nledez/printer/doc/src/img/DSC04834.jpg

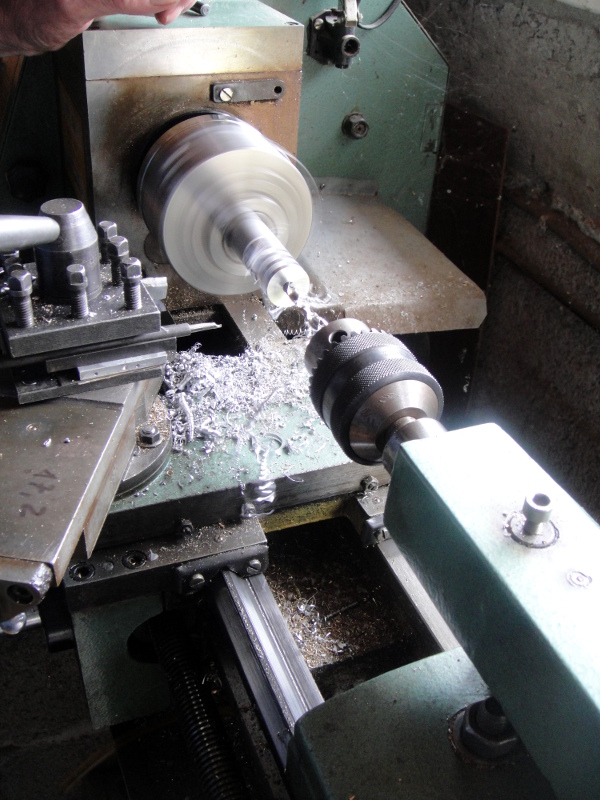
doc/src/img/DSC04834.jpg
