nledez/printer/doc/src/img/DSC04835.jpg

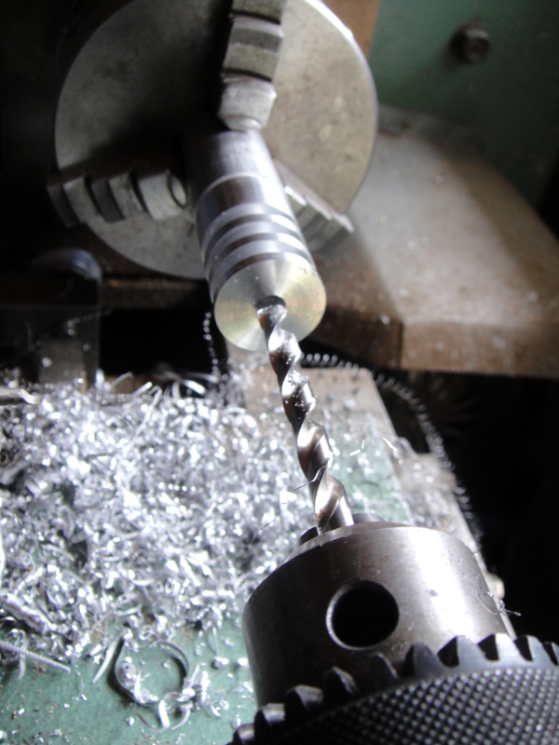
doc/src/img/DSC04835.jpg
