nledez/printer/doc/src/img/DSC04836.jpg

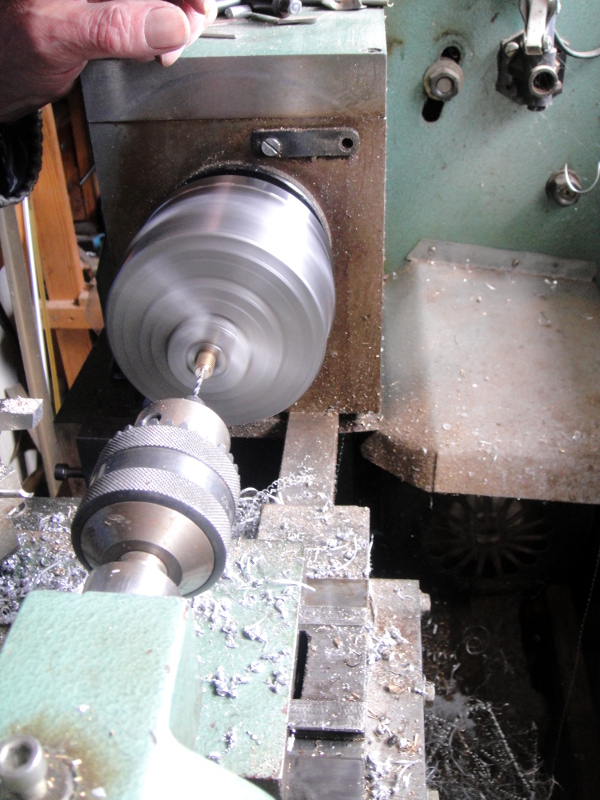
doc/src/img/DSC04836.jpg
