nledez/printer/doc/src/img/DSC04837.jpg

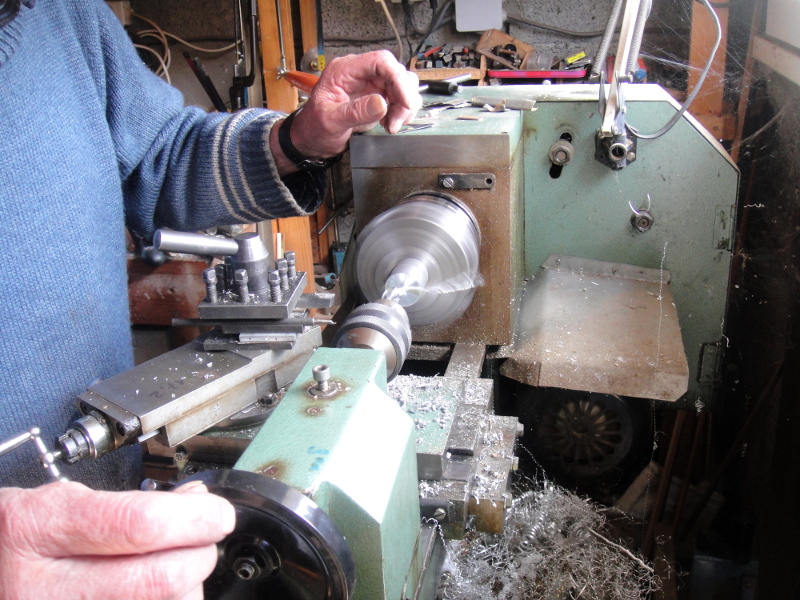
doc/src/img/DSC04837.jpg
