nledez/printer/doc/src/img/DSC04839.jpg

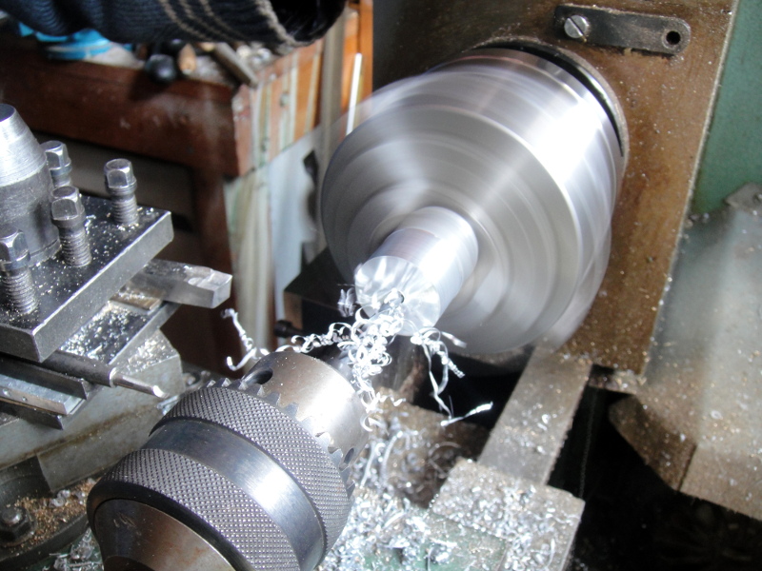
doc/src/img/DSC04839.jpg
