nledez/printer/doc/src/img/DSC04840.jpg

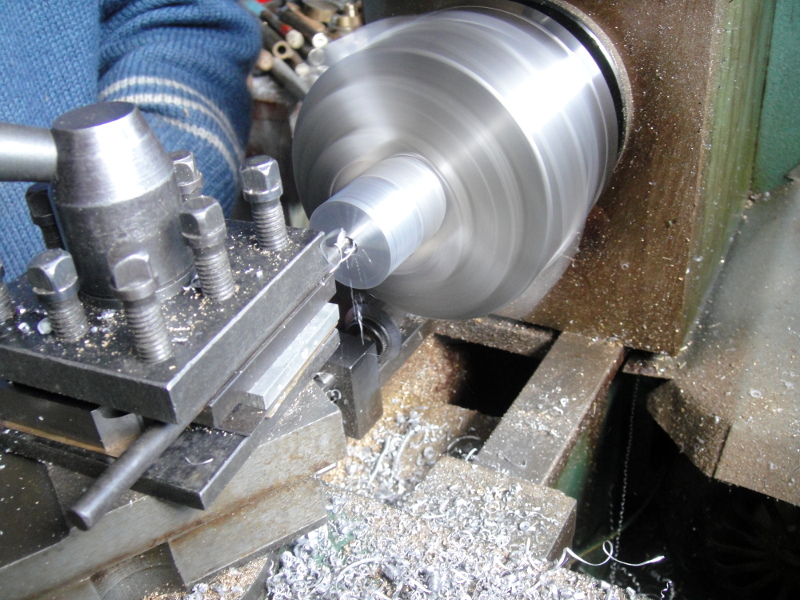
doc/src/img/DSC04840.jpg
