nledez/printer/doc/src/img/DSC04842.jpg

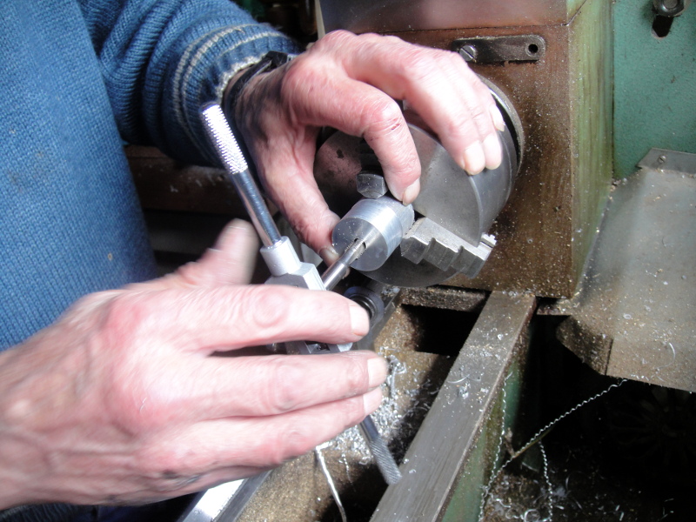
doc/src/img/DSC04842.jpg
