nledez/printer/doc/src/img/DSC04844.jpg

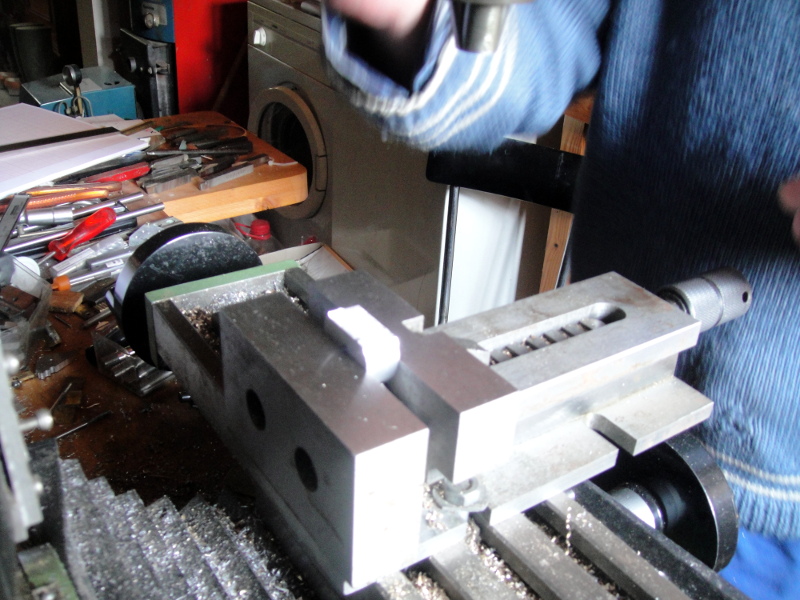
doc/src/img/DSC04844.jpg
