nledez/printer/doc/src/img/DSC04845.jpg

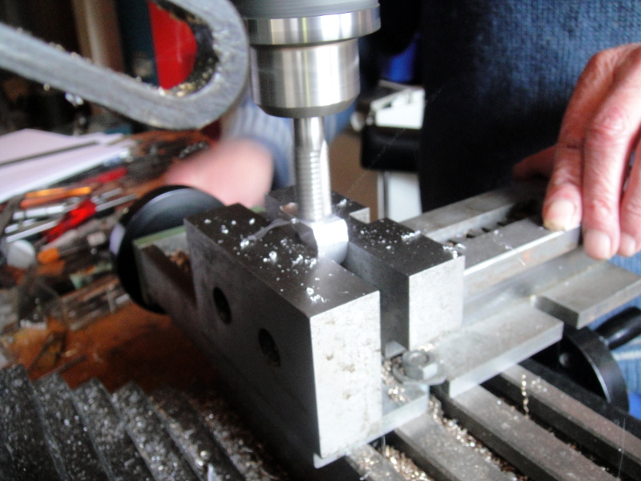
doc/src/img/DSC04845.jpg
