nledez/printer/doc/src/img/DSC04846.jpg

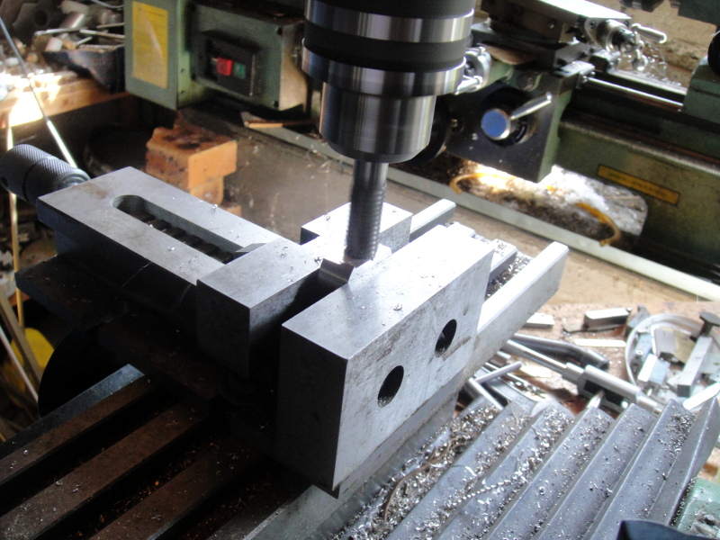
doc/src/img/DSC04846.jpg
