nledez/printer/doc/src/img/DSC04848.jpg

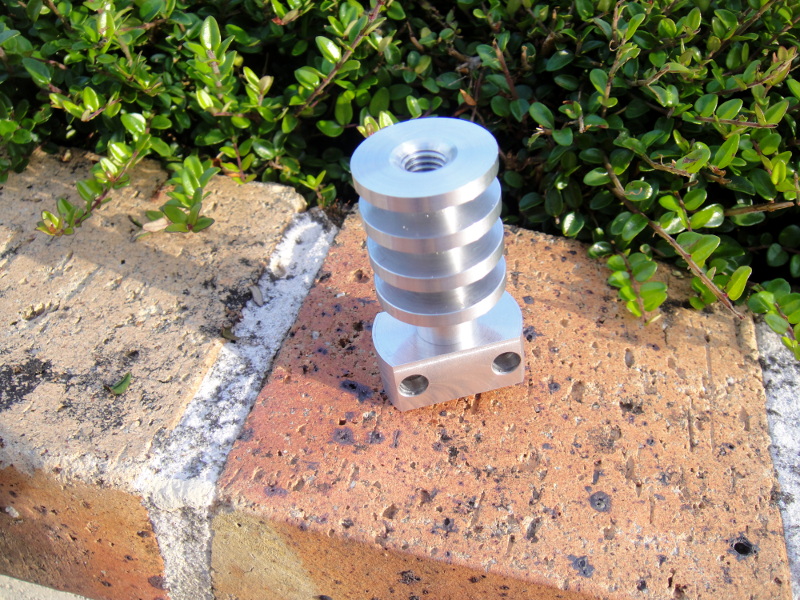
doc/src/img/DSC04848.jpg
