nledez/printer/doc/src/img/frame.jpg

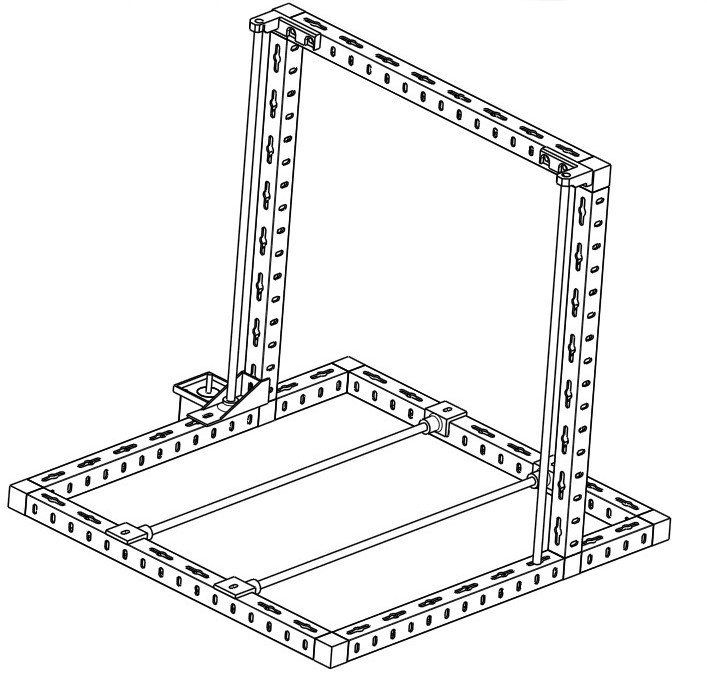
doc/src/img/frame.jpg
