nledez/printer/doc/src/img/funduino01.jpg

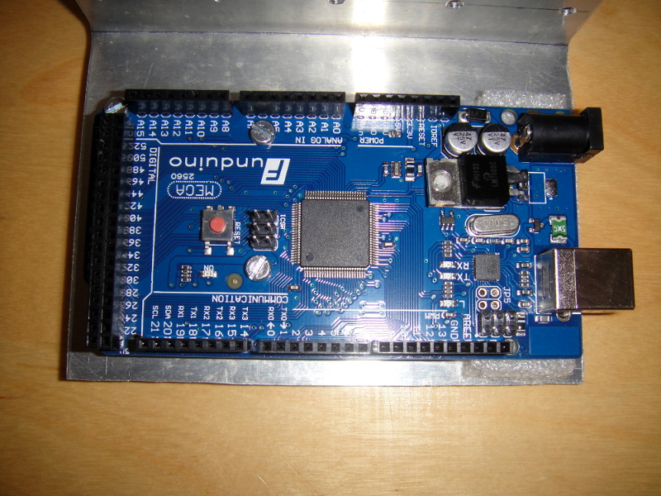
doc/src/img/funduino01.jpg
