nledez/printer/doc/src/img/ramps01.jpg

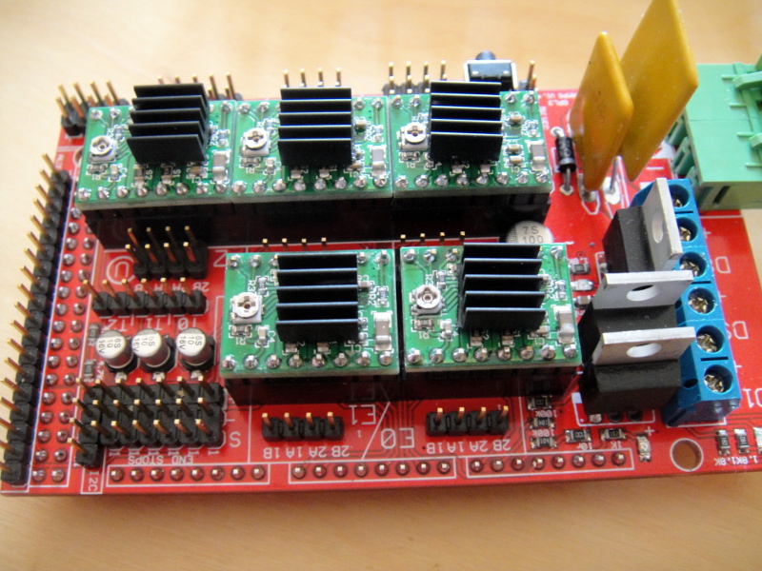
doc/src/img/ramps01.jpg
