nledez/printer/frame/printer.stp

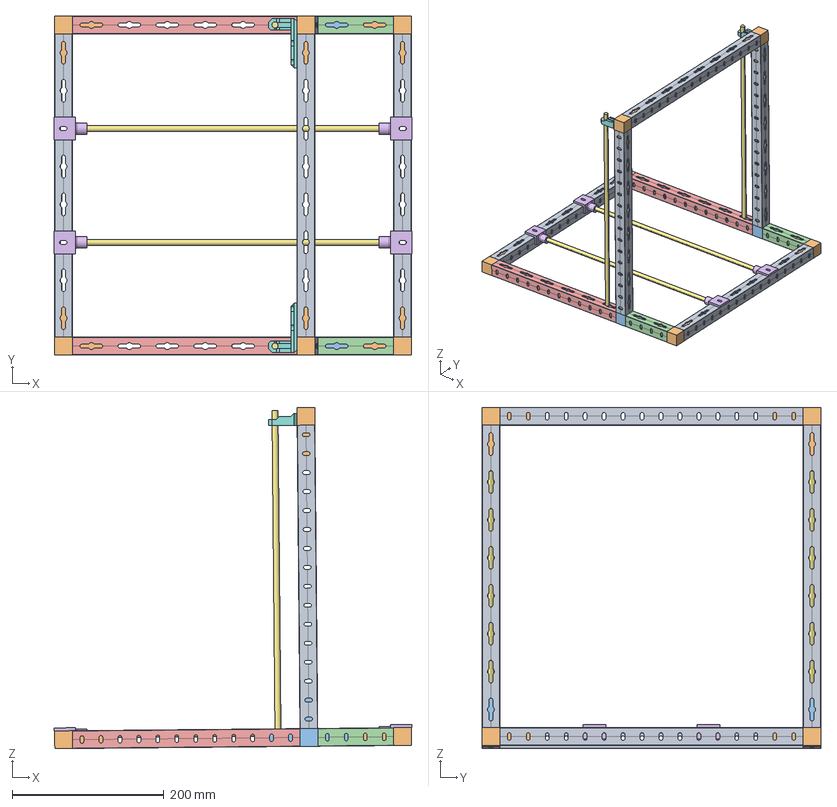
[picture p20: CAD file, 2014-05-22]
frame/printer.stp
471.5 x 447.0 x 450.2 mm
