nledez/printer/head/core.stl

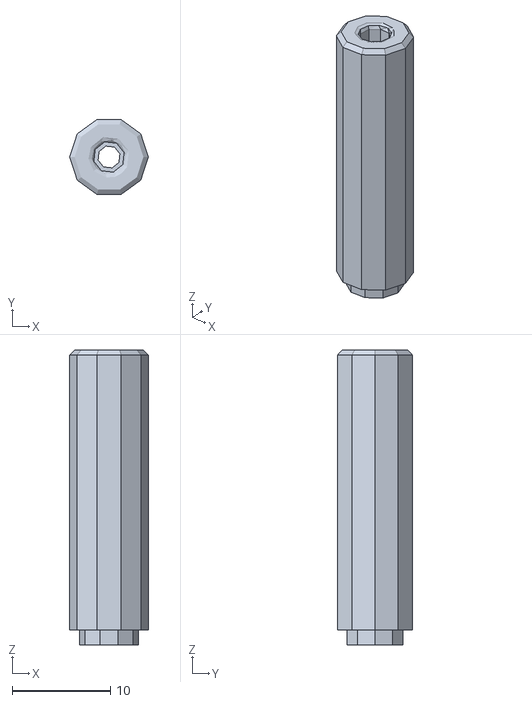
[picture p21: CAD file, 2014-06-01]
head/core.stl
8.00 x 7.61 x 30.0
