nledez/printer/import/Prusa_Mendel_i3_Rework/ENDSTOP-Z-HOLDER-V2.stl

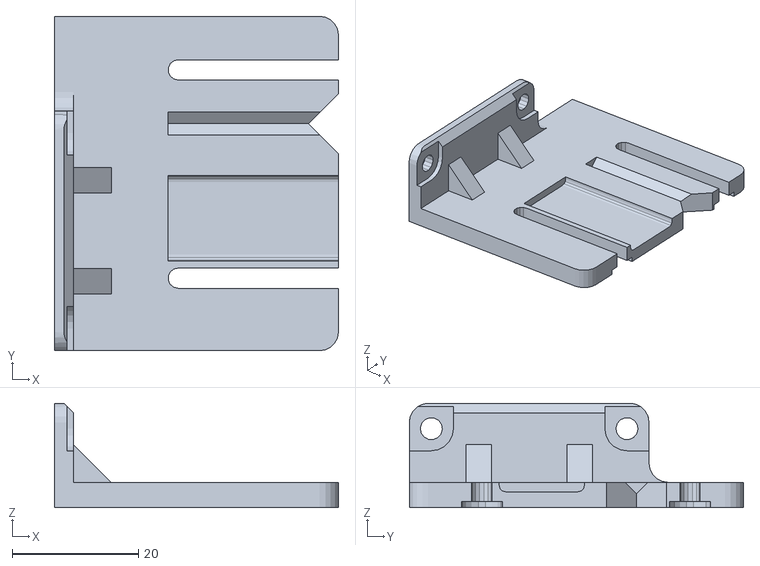
[picture p22: CAD file, 2014-05-20]
import/Prusa_Mendel_i3_Rework/ENDSTOP-Z-HOLDER-V2.stl
45.0 x 53.0 x 16.5
