nledez/printer/specific/Z-Axis-Top-Right.stl

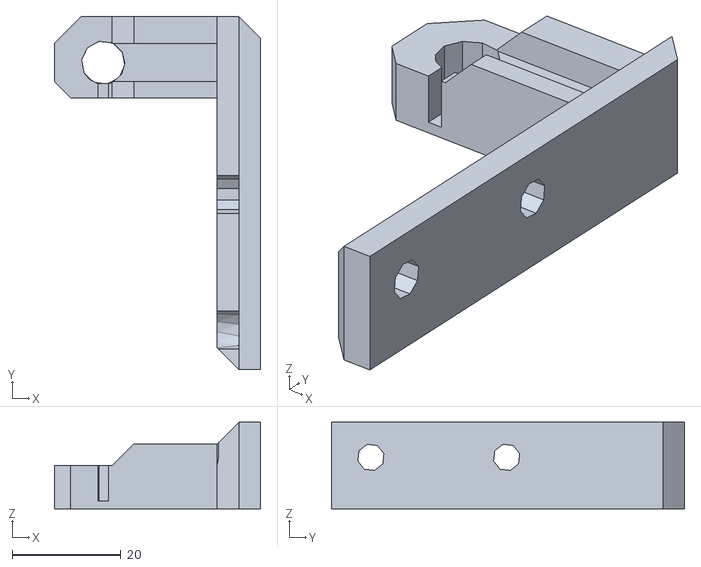
[picture p23: CAD file, 2014-05-22]
specific/Z-Axis-Top-Right.stl
38.0 x 65.0 x 16.0
