nledez/printer/tubes/profile_450.stl

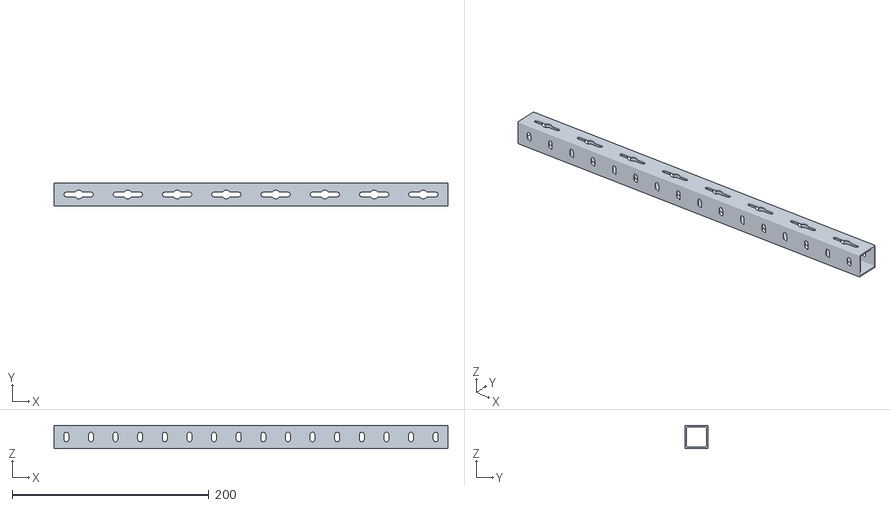
[picture p24: CAD file, 2014-05-17]
tubes/profile_450.stl
400.0 x 23.5 x 23.5
