nledez/printer/head/cooler.stl

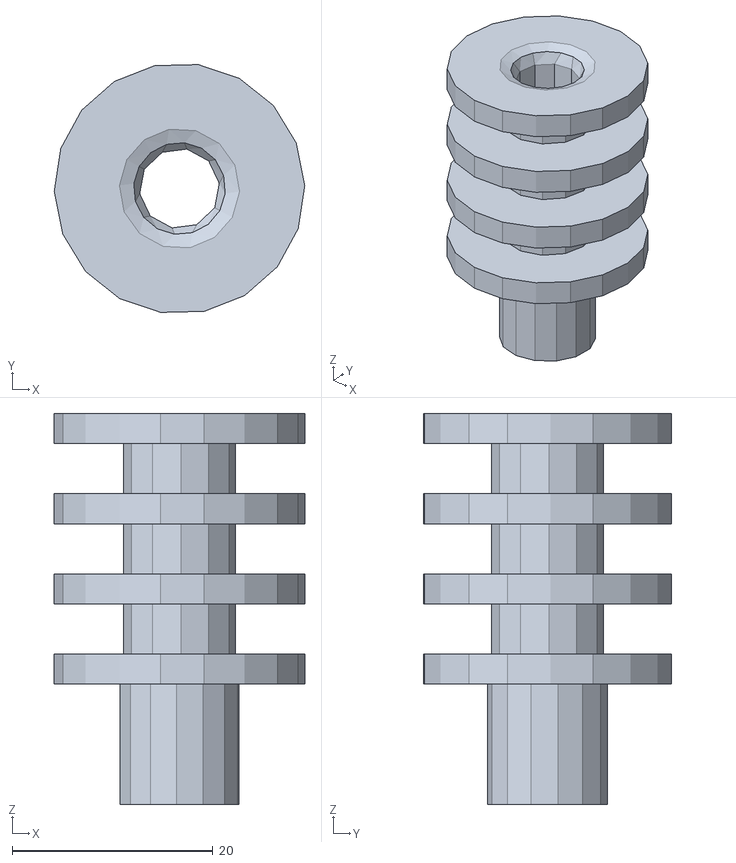
[picture p25: CAD file, 2014-06-01]
head/cooler.stl
25.0 x 24.7 x 39.0
