nledez/printer/import/Prusa_Mendel_i3_Rework/BODY-EXTRUDEUR-WADE-with-support.stl

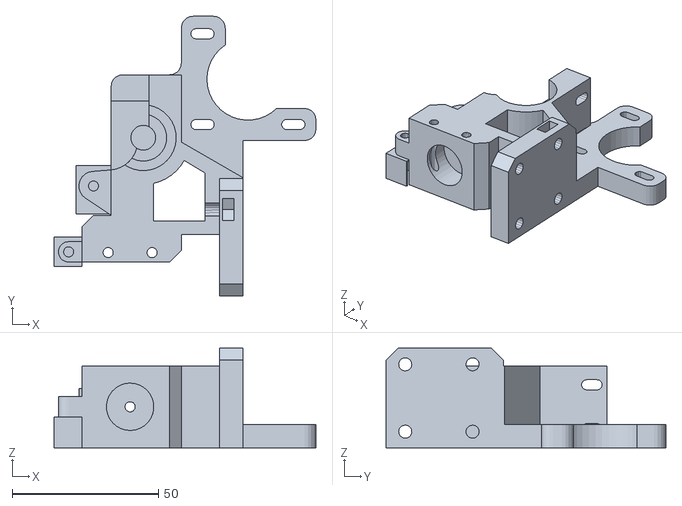
[picture p26: CAD file, 2014-05-20]
import/Prusa_Mendel_i3_Rework/BODY-EXTRUDEUR-WADE-with-support.stl
89.5 x 95.5 x 34.0
