nledez/printer/tubes/L.stl

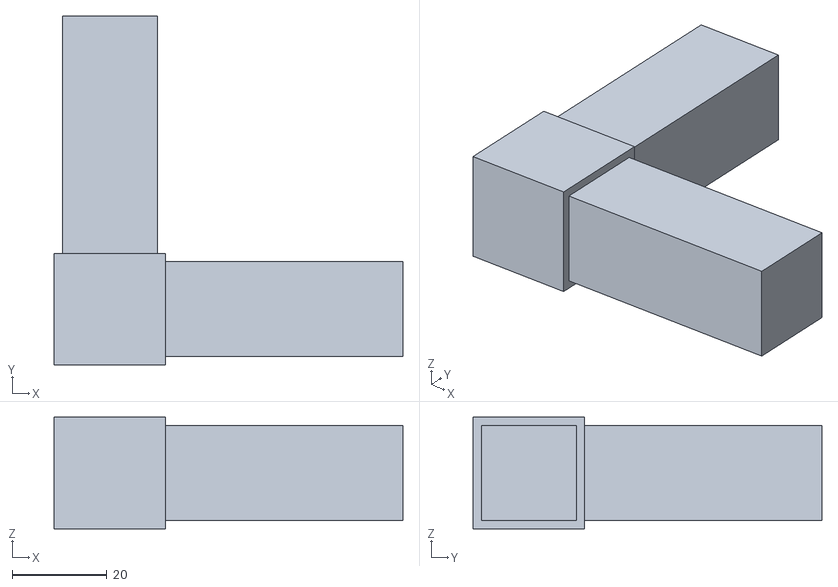
[picture p27: CAD file, 2014-05-17]
tubes/L.stl
73.5 x 73.5 x 23.5
