nledez/printer/head/heater.stl

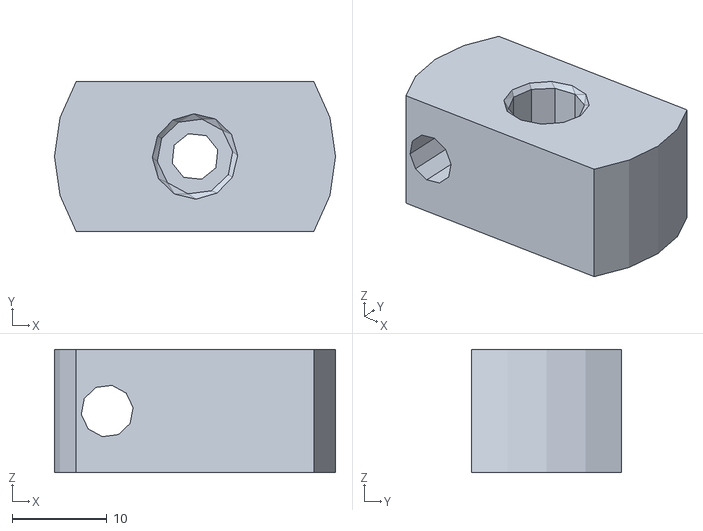
[picture p28: CAD file, 2014-06-01]
head/heater.stl
29.6 x 15.8 x 13.0
