nledez/printer/import/Prusa_Mendel_i3_Rework/Y-MOTOR.stl

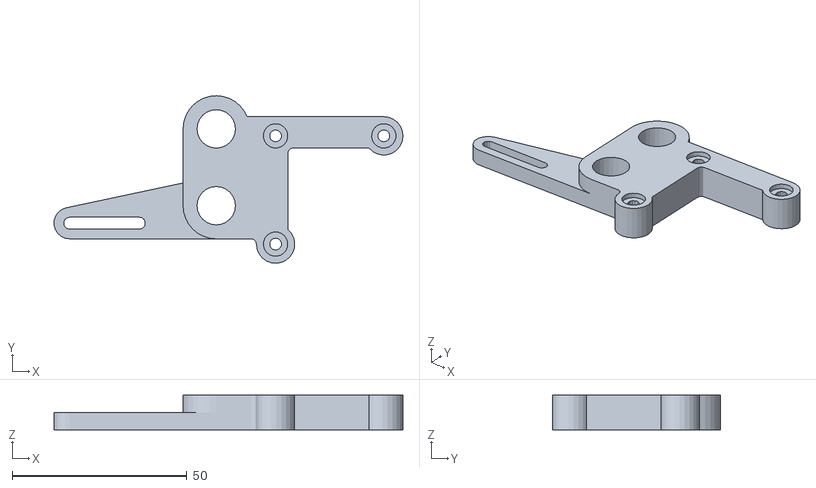
[picture p29: CAD file, 2014-05-20]
import/Prusa_Mendel_i3_Rework/Y-MOTOR.stl
100.0 x 48.0 x 10.0
