nledez/printer/specific/support_stub.stl

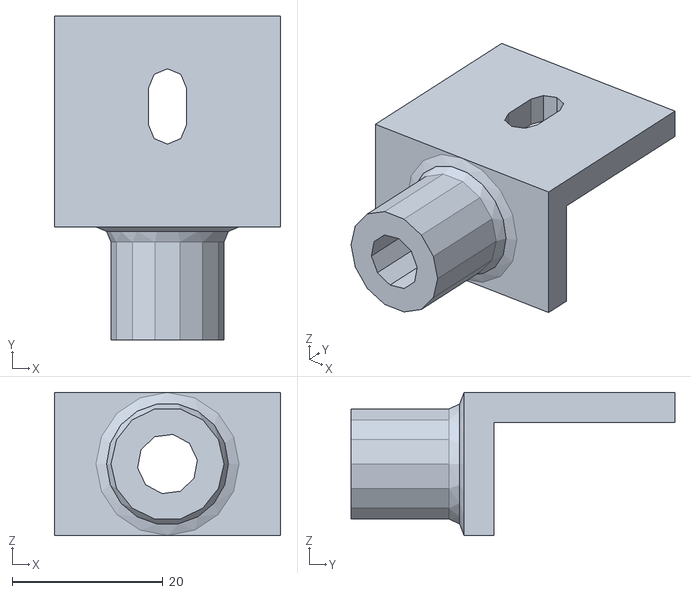
[picture p30: CAD file, 2014-05-19]
specific/support_stub.stl
30.0 x 43.0 x 19.0
