nledez/printer/head/printing_nozzle.stl

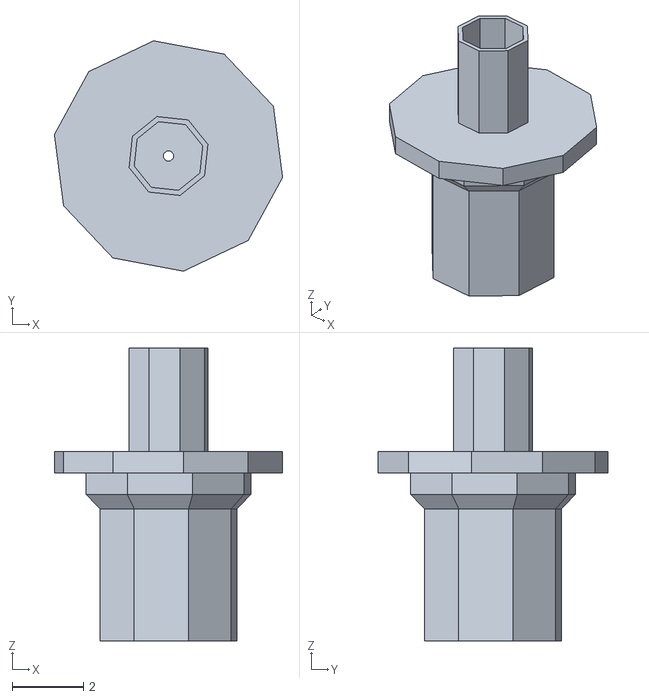
[picture p31: CAD file, 2014-05-23]
head/printing_nozzle.stl
6.39 x 6.45 x 8.20
