nledez/printer/import/Prusa_Mendel_i3_Rework/Z-AXIS-TOP-RIGHT-V2.stl

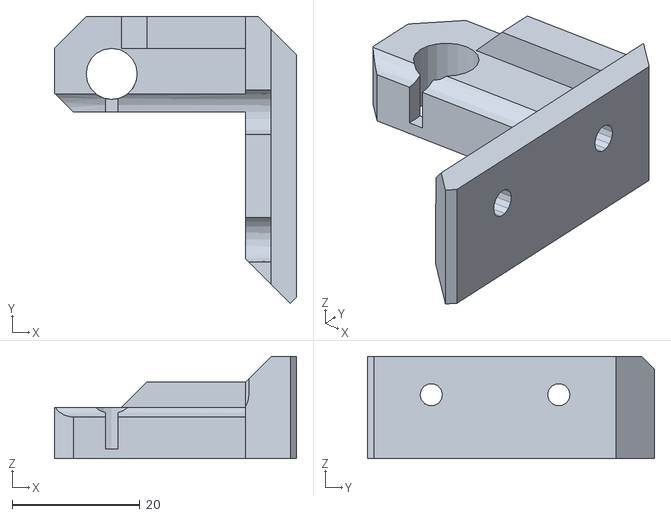
[picture p32: CAD file, 2014-05-20]
import/Prusa_Mendel_i3_Rework/Z-AXIS-TOP-RIGHT-V2.stl
38.0 x 45.0 x 16.0
