nledez/printer/tubes/T.stl

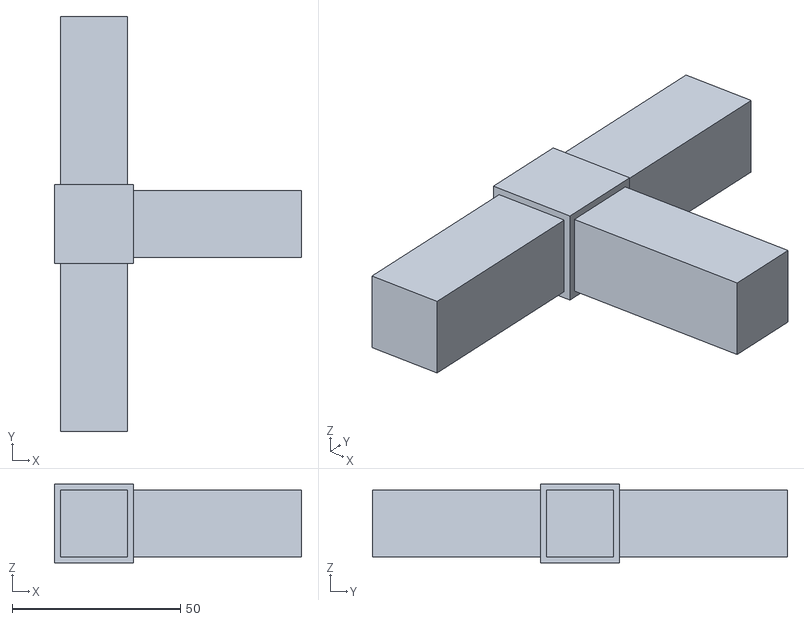
[picture p33: CAD file, 2014-05-17]
tubes/T.stl
73.5 x 123.5 x 23.5
