nledez/printer/import/Prusa_Mendel_i3_Rework/FAN-DUCT.stl

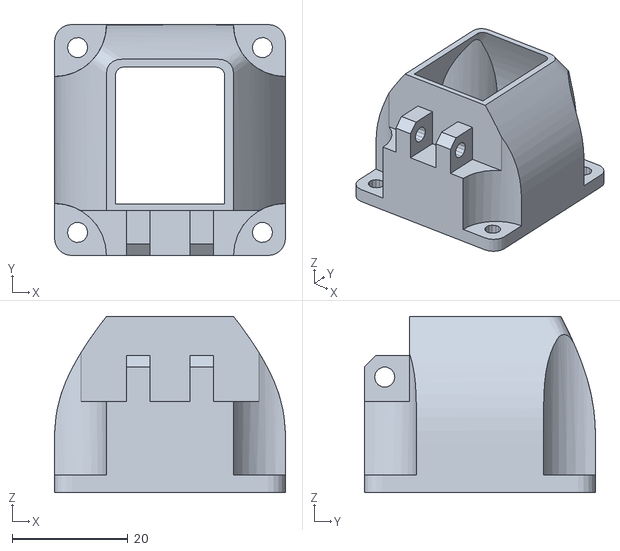
[picture p34: CAD file, 2014-05-20]
import/Prusa_Mendel_i3_Rework/FAN-DUCT.stl
40.0 x 40.0 x 30.5
