nledez/printer/tubes/profile_150.stl

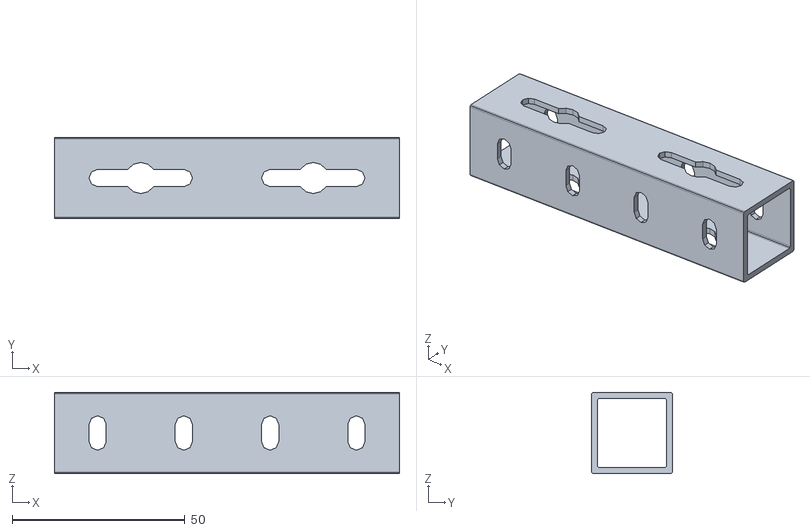
[picture p35: CAD file, 2014-05-17]
tubes/profile_150.stl
100.0 x 23.5 x 23.5
