nledez/printer/import/Prusa_Mendel_i3_Rework/WADE-BIG-GEAR.stl

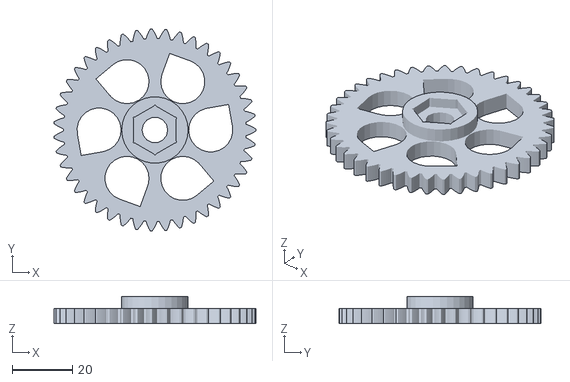
[picture p36: CAD file, 2014-05-20]
import/Prusa_Mendel_i3_Rework/WADE-BIG-GEAR.stl
66.9 x 67.0 x 9.00
