nledez/printer/tubes/profile_300.stl

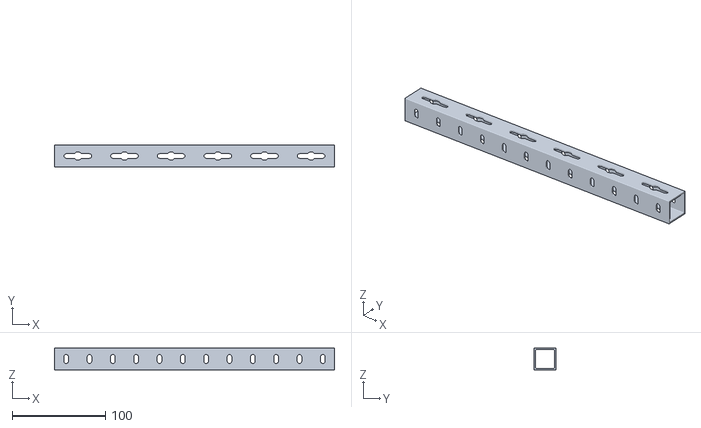
[picture p37: CAD file, 2014-05-17]
tubes/profile_300.stl
300.0 x 23.5 x 23.5
