nledez/printer/import/Prusa_Mendel_i3_Rework/BODY-EXTRUDEUR-WADE.stl

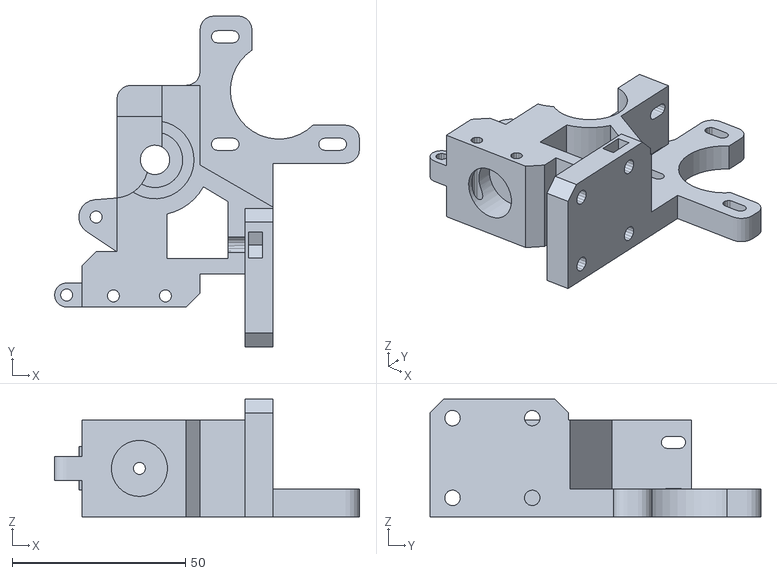
[picture p38: CAD file, 2014-05-20]
import/Prusa_Mendel_i3_Rework/BODY-EXTRUDEUR-WADE.stl
88.0 x 95.5 x 34.0
