nledez/printer/import/Prusa_Mendel_i3_Rework/BODY-EXTRUDEUR-WADE-1.75mm-with-support.stl

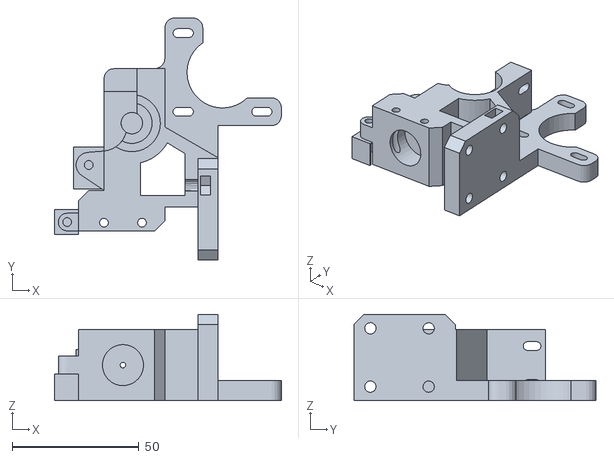
[picture p39: CAD file, 2014-05-20]
import/Prusa_Mendel_i3_Rework/BODY-EXTRUDEUR-WADE-1.75mm-with-support.stl
89.5 x 95.5 x 34.0
