nledez/printer/import/Prusa_Mendel_i3_Rework/Y-IDLER.stl

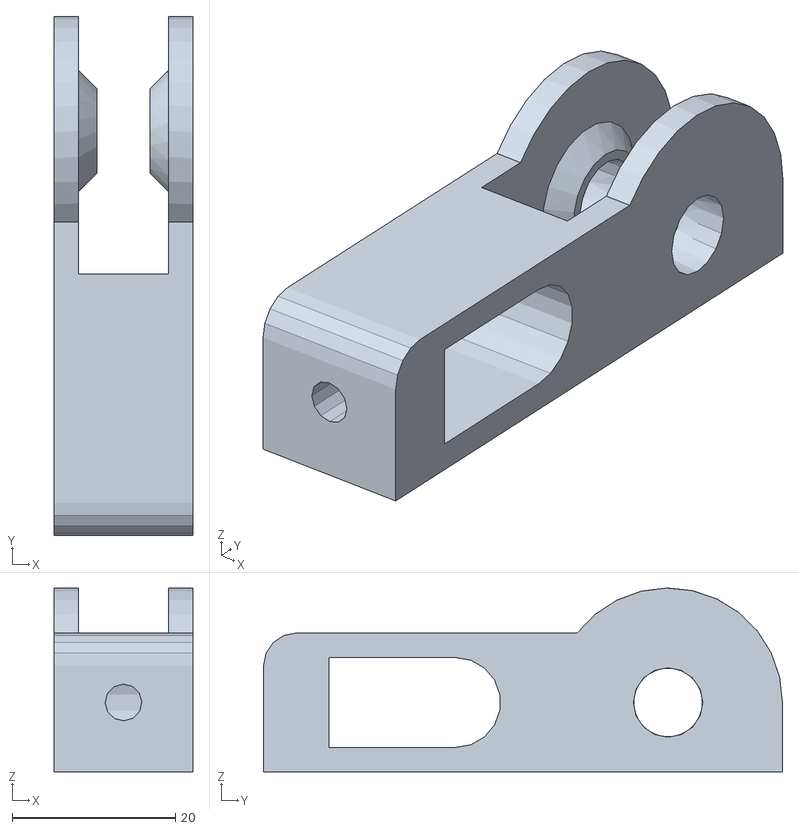
[picture p40: CAD file, 2014-05-20]
import/Prusa_Mendel_i3_Rework/Y-IDLER.stl
17.0 x 63.5 x 22.5
