nledez/printer/import/Prusa_Mendel_i3_Rework/Y-BELT-HOLDER.stl

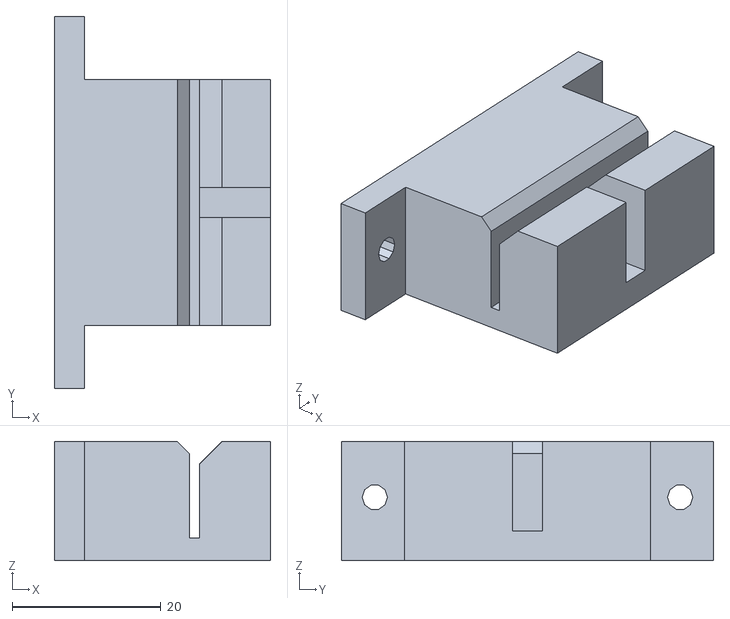
[picture p41: CAD file, 2014-05-20]
import/Prusa_Mendel_i3_Rework/Y-BELT-HOLDER.stl
29.0 x 50.0 x 16.0
