nledez/printer/import/Prusa_Mendel_i3_Rework/Z-AXIS-BOTTOM-RIGHT-V2.stl

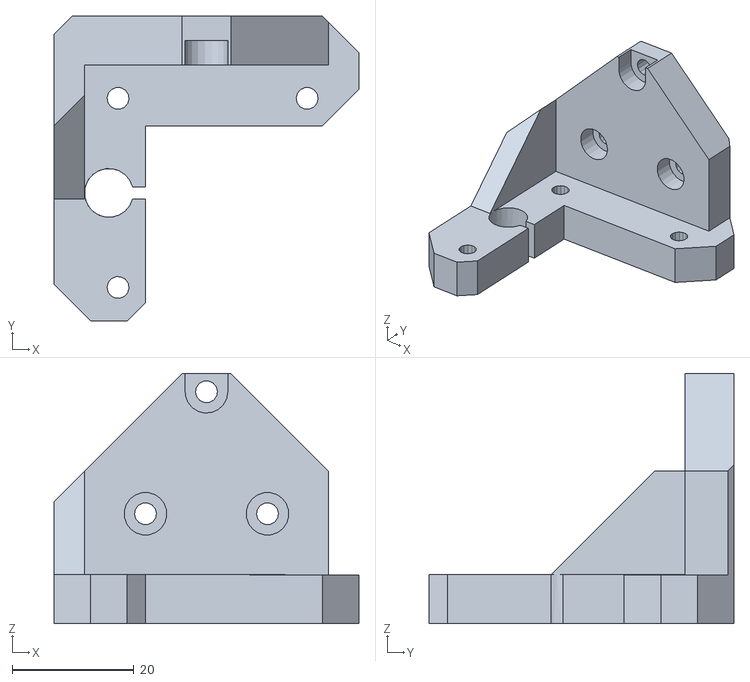
[picture p42: CAD file, 2014-05-20]
import/Prusa_Mendel_i3_Rework/Z-AXIS-BOTTOM-RIGHT-V2.stl
50.0 x 50.0 x 41.0
