nledez/printer/import/Prusa_Mendel_i3_Rework/X-CARRIAGE.stl

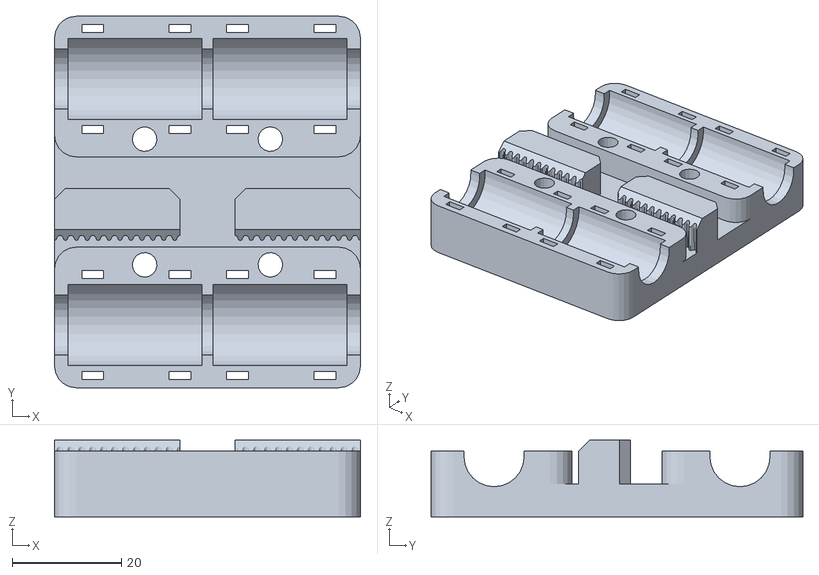
[picture p43: CAD file, 2014-05-20]
import/Prusa_Mendel_i3_Rework/X-CARRIAGE.stl
56.0 x 68.0 x 14.0
