nledez/printer/import/Prusa_Mendel_i3_Rework/Y-CORNERS.stl

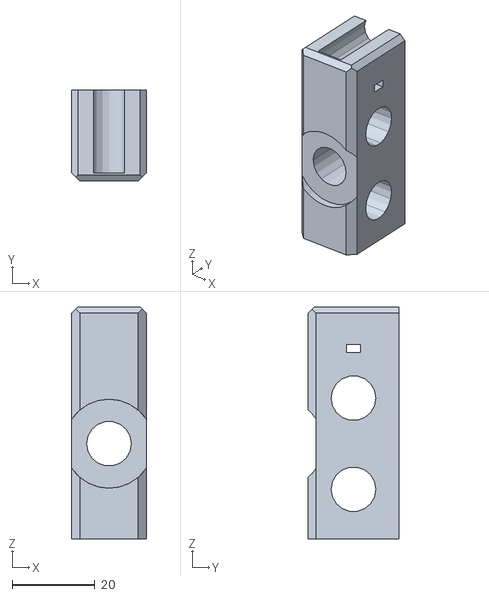
[picture p44: CAD file, 2014-05-20]
import/Prusa_Mendel_i3_Rework/Y-CORNERS.stl
18.0 x 22.0 x 56.0
