nledez/printer/import/Prusa_Mendel_i3_Rework/X-END-IDLER.stl

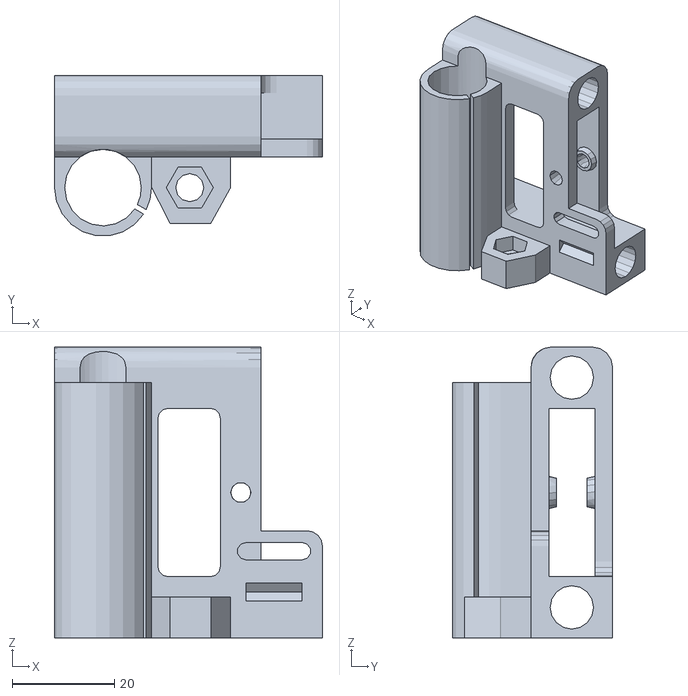
[picture p45: CAD file, 2014-05-20]
import/Prusa_Mendel_i3_Rework/X-END-IDLER.stl
52.5 x 31.4 x 57.0
