nledez/printer/import/Prusa_Mendel_i3_Rework/EXTRUDER-IDLER-avec-guide.stl

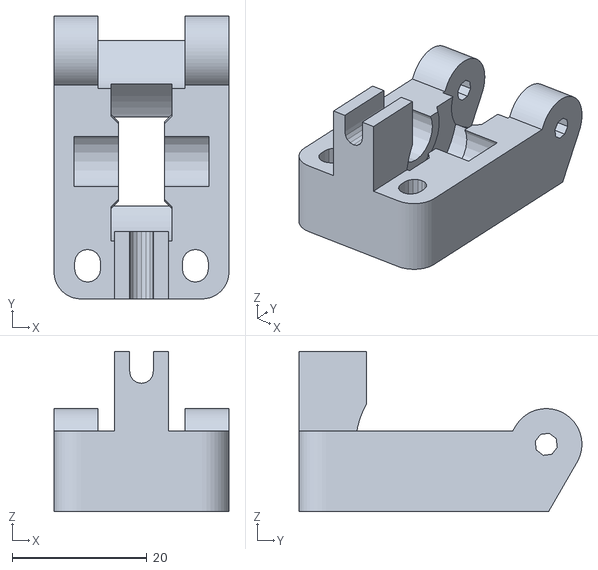
[picture p46: CAD file, 2014-05-20]
import/Prusa_Mendel_i3_Rework/EXTRUDER-IDLER-avec-guide.stl
26.0 x 42.0 x 23.8
