nledez/printer/import/Prusa_Mendel_i3_Rework/X-END-MOTOR-V2.stl

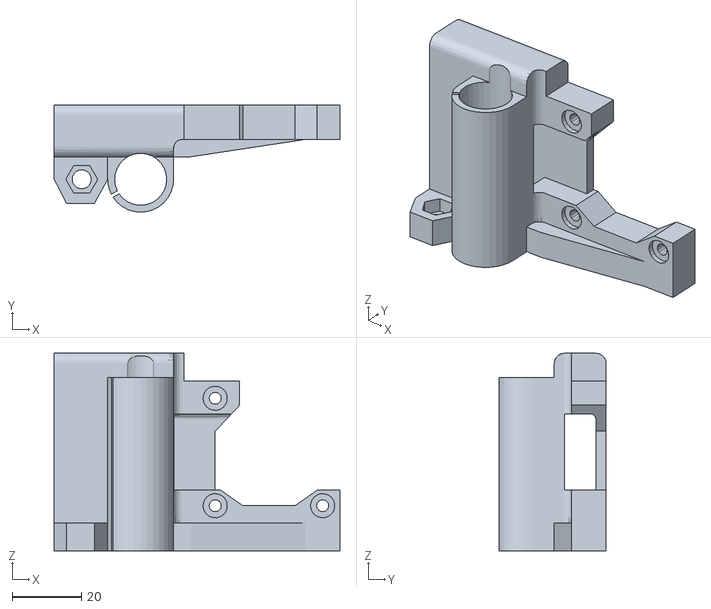
[picture p47: CAD file, 2014-05-20]
import/Prusa_Mendel_i3_Rework/X-END-MOTOR-V2.stl
82.5 x 31.0 x 57.0
