nledez/printer/import/Prusa_Mendel_i3_Rework/WADE-SMALL-GEAR.stl

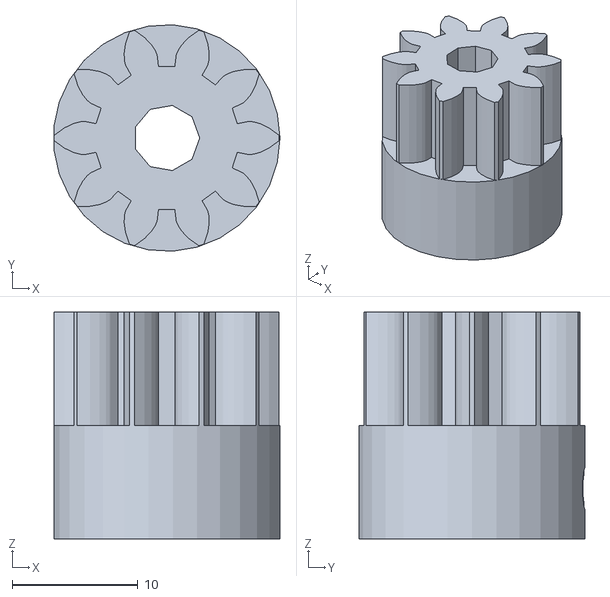
[picture p48: CAD file, 2014-05-20]
import/Prusa_Mendel_i3_Rework/WADE-SMALL-GEAR.stl
17.9 x 18.0 x 18.0
