nledez/printer/(list of files, cad)

Other CAD files:
specific/Z-Axis-Top-Left.stl
import/Prusa_Mendel_i3_Rework/Z-AXIS-TOP-LEFT-V2.stl
import/Prusa_Mendel_i3_Rework/Z-AXIS-BOTTOM-LEFT-V2.stl
frame/printer.CATProduct
head/cooler.CATPart
head/core.CATPart
head/head.CATProduct
head/heater.CATPart
head/printing_nozzle.CATPart
import/Prusa_Mendel_i3_Rework/ARDUINO-WASHER.stl
specific/Motor-Support-bottom-left.CATPart
specific/Motor.CATPart
specific/Motor_Support_bottom_right.CATPart
specific/Z-Axis-Top-Left.CATPart
specific/Z-Axis-Top-Right.CATPart
specific/stub_X.CATPart
specific/stub_Z.CATPart
specific/support_stub.CATPart
tubes/L.CATPart
tubes/T.CATPart
tubes/profile_150.CATPart
tubes/profile_300.CATPart
tubes/profile_450.CATPart
tubes/profile_500.CATPart
tubes/src/Profile.CATPart
