nledez/printer/doc/printer.tex

\documentclass[a4paper,12pt]{article}%
\usepackage[utf8]{inputenc}%
\usepackage[francais]{babel}%
\usepackage[T1]{fontenc}%
\usepackage{eurosym}%
\usepackage{csvsimple}%
\usepackage{graphicx}%
\usepackage[pdftex,%
    pdfauthor={C. Meichel},%
    pdftitle={3D-Printer},%
    pdfsubject={Conception d'une imprimante 3D},%
    pdfkeywords={reprap,printer},%
    pdfproducer={Latex},%
    pdfcreator={pdflatex}]{hyperref}%
\usepackage{float}%
%\floatstyle{boxed}%
\restylefloat{figure}%
%
\author{C. Meichel}%
\title{3D-Printer}%
\date{\today}%
%
\begin{document}%
\maketitle%
%
\clearpage%
\tableofcontents%
\clearpage%
%
\input{presentation}%
\input{conception}%
\input{mise_en_oeuvre}%
%
\end{document}%
