nledez/printer/frame/frame.pdf

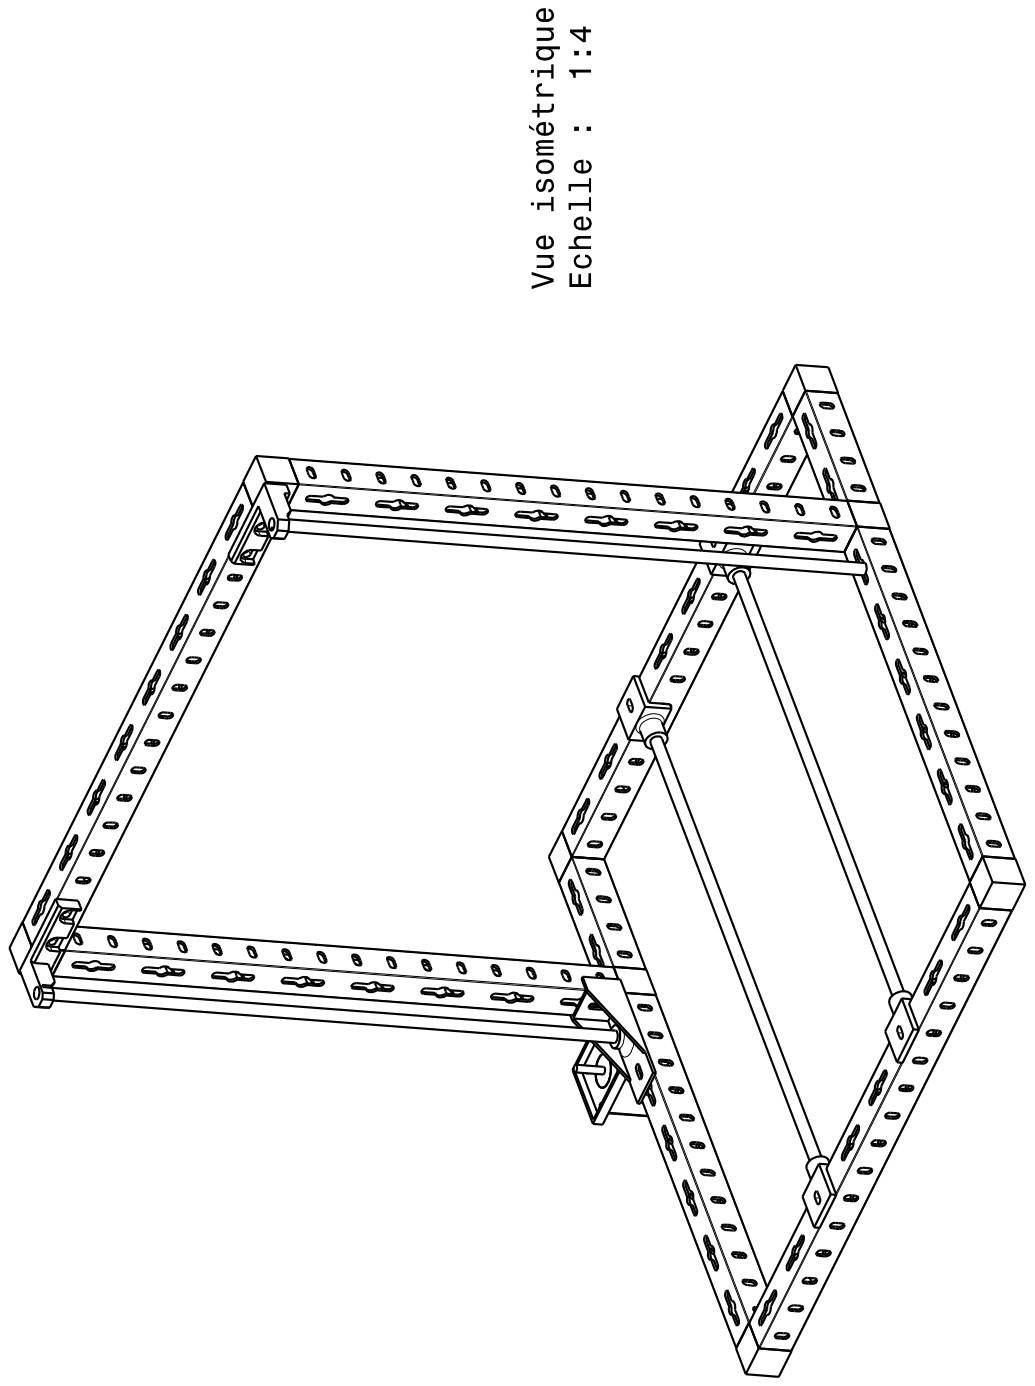
[picture p49: page 1]
