nledez/printer/frame/tete.pdf

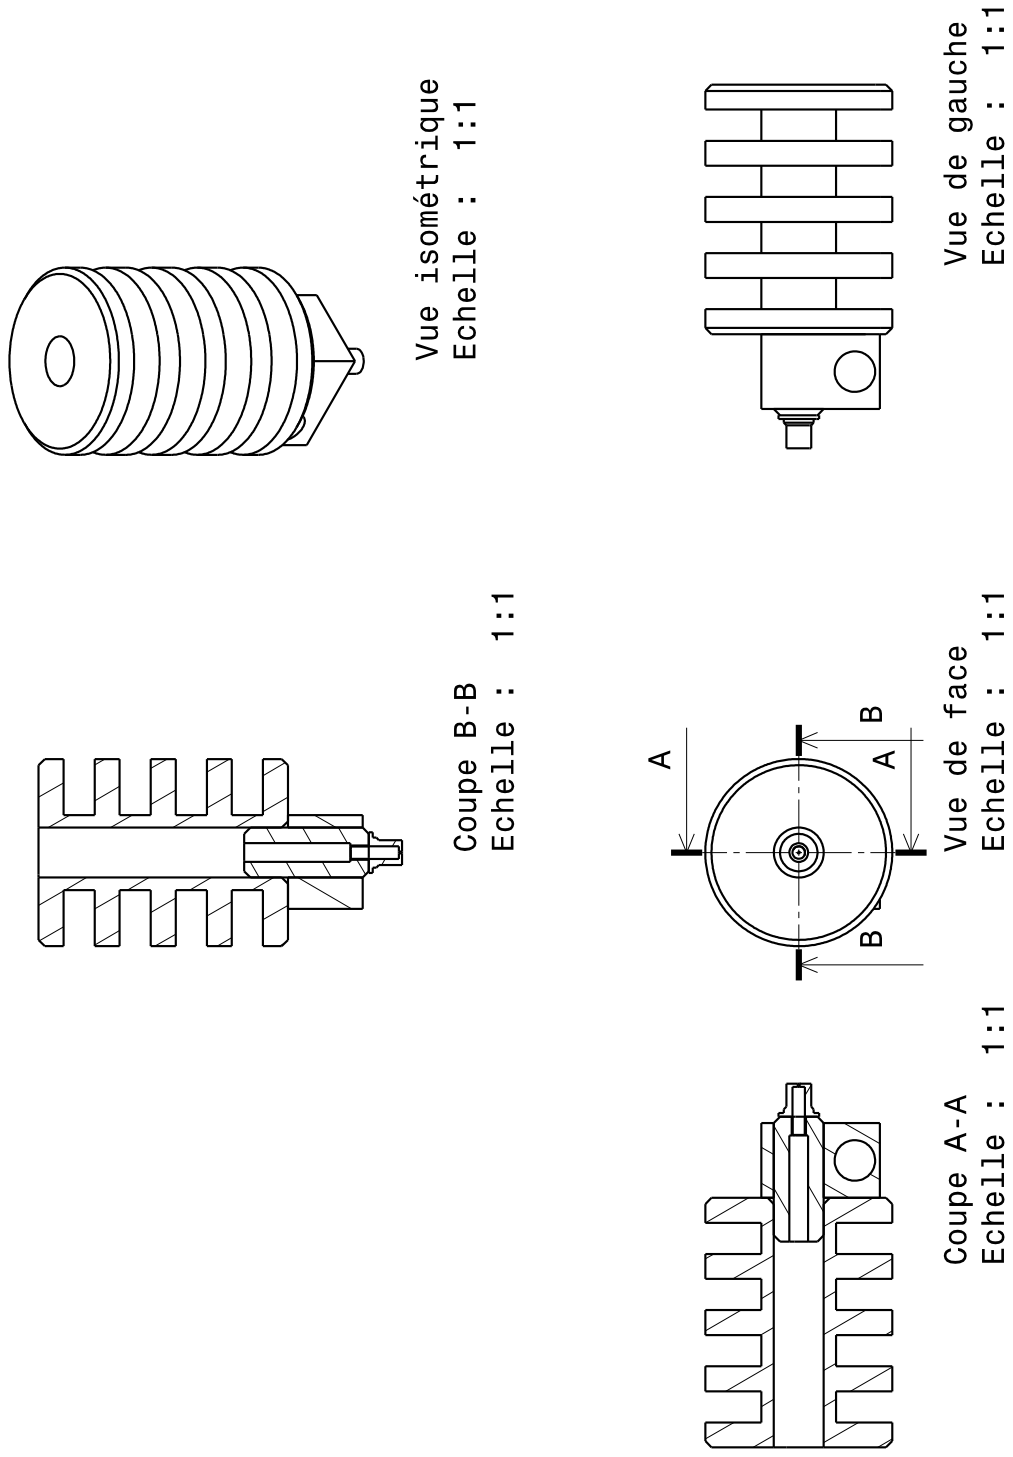
[picture p50: page 1]
