nledez/printer/(commit log)

2014-05-17 resizing frame
    [printer.CATProduct, profile_100.CATPart, profile_150.CATPart, profile_200.CATPart, profile_250.CATPart, profile_350.CATPart, profile_400.CATPart, profile_450.CATPart]
2014-05-17 stl files
    [L.stl, T.stl, profile_150.stl, profile_300.stl, profile_450.stl, profile_500.stl]
2014-05-17 Stub X
    [printer.CATProduct, stub_X.CATPart, support_stub.CATPart, support_stub.stl]
2014-05-19 New stub bracket
    [printer.CATProduct, stub_X.CATPart, support_stub.CATPart, support_stub.stl]
2014-05-20 external items from Prusa
    [ARDUINO-WASHER.stl, BODY-EXTRUDEUR-WADE-1.75mm-with-support.stl, BODY-EXTRUDEUR-WADE-with-support.stl, BODY-EXTRUDEUR-WADE.stl, ENDSTOP-Z-HOLDER-V2.stl, EXTRUDER-IDLER-avec-guide.stl, FAN-DUCT.stl, WADE-BIG-GEAR.stl]
2014-05-22 Update Z-brackets
    [Z-Axis-Top-Left.CATPart, Z-Axis-Top-Left.stl, Z-Axis-Top-Right.CATPart, Z-Axis-Top-Right.stl, printer.CATProduct, printer.stp, stub_Z.CATPart]
2014-05-23 Printing nozzle
    [printing_nozzle.CATPart, printing_nozzle.stl]
2014-05-25 Bill Of Materials
    [bom.csv]
2014-05-26 Update bom
    [bom.csv]
2014-05-26 heater & drafting
    [head.CATPart, heater.CATProduct, printing_nozzle.CATPart]
2014-06-01 printing head design
    [cooler.CATPart, cooler.stl, core.CATPart, core.stl, head.CATPart, head.CATProduct, heater.CATPart, heater.CATProduct]
2014-06-04 Motor bracket
    [Motor-Support-bottom-left.CATPart, Motor.CATPart, Z-Axis-Top-Left.CATPart, Z-Axis-Top-Right.CATPart, printer.CATProduct]
2014-06-05 Motor brackets
    [Motor-Support-bottom-left.CATPart, Motor_Support_bottom_right.CATPart, printer.CATProduct]
